tetiti20/Mowgli_PCB/README.md

# Mowgli_PCB
PI-HAT for mower OpenMower Mowgli project


https://github.com/Mowglifrenchtouch  
https://github.com/juditech3D/Guide-DIY-OpenMower-Mowgli-pour-Robots-Tondeuses-Yard500-et-500B

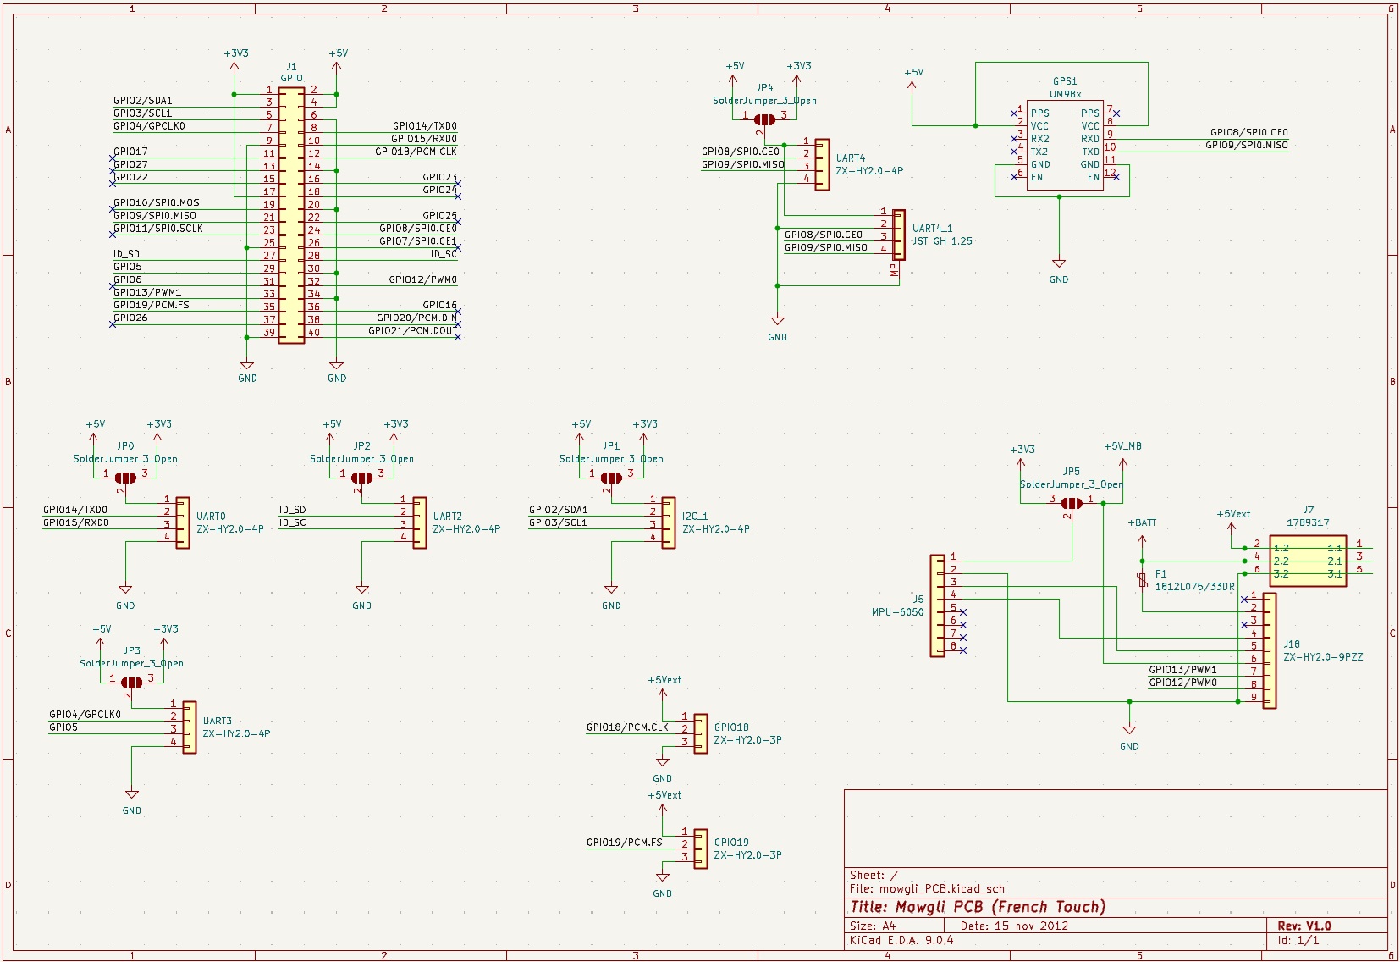
[picture p1: photos/Schéma.jpg]
schema
