tetiti20/Mowgli_PCB/Nomenclature Mowgli.ods

 | Prix lot | Prix Unitaire | Quantité | Total
Yardforce 500B classic | 329,00 € | 329,00 € | 1 | 329,00 € | https://www.jardin-affaires.com/materiels-de-motoculture/robot-tondeuse/robot-tondeuse-500-m-avec-bluetooth.html
Convertisseur DC/DC XL4015 | 3,19 € | 3,19 € | 1 | 3,19 € | https://fr.aliexpress.com/item/1005007105816094.html
MPU-6050 GY-521 | 2,87 € | 2,87 € | 1 | 2,87 € | https://fr.aliexpress.com/item/1005005281279590.html
Câble RG316 SMA female /MMCX 20cm | 1,83 € | 1,83 € | 1 | 1,83 € | https://fr.aliexpress.com/item/1005004620858652.html
GPS UM980 | 122,69 € | 122,69 € | 1 | 122,69 € | https://fr.aliexpress.com/item/1005007658786847.html
Antenne HA901A | 20,70 € | 20,70 € | 1 | 20,70 € | https://fr.aliexpress.com/item/1005007201937968.html
Stlink V2
Raspeberry PI4 4G | 50,00 € | 50,00 € | 1 | 50,00 € | leboncoin
SD 32Gb | 8,90 € | 8,90 € | 1 | 8,90 € | https://www.amazon.fr/SanDisk-M%C3%A9moire-microSDHC-Adaptateur-homologu%C3%A9e/dp/B08GY9NYRM?th=1 (https://www.amazon.fr/SanDisk-Mémoire-microSDHC-Adaptateur-homologuée/dp/B08GY9NYRM?th=1)
Clé USB TPLINK AC1300 | 16,99 € | 16,99 € | 1 | 16,99 € | https://www.amazon.fr/dp/B0859M539M?ref=ppx_yo2ov_dt_b_fed_asin_title&th=1
PCB | 9,46 € | 1,89 € | 1 | 1,89 € | PCBWAY
Fusible 1812L075/33DR | 5,85 € | 0,60 € | 1 | 0,60 € | https://fr.rs-online.com/web/p/products/7874259/
Connecteur femelle 2x20 | 2,99 € | 0,30 € | 1 | 0,30 € | https://fr.aliexpress.com/item/33004522737.html
Connecteur femelle 2x6 | 1,92 € | 0,19 € | 1 | 0,19 € | https://fr.aliexpress.com/item/33004522737.html
J18 09P HY2,0 | 6,39 € | 0,06 € | 1 | 0,06 € | https://fr.aliexpress.com/item/1005005320010110.html
3P HY2,0 | 3,39 € | 0,03 € | 2 | 0,07 € | https://fr.aliexpress.com/item/1005005320010110.html
4P HY2,0 | 3,69 € | 0,74 € | 5 | 3,69 € | https://fr.aliexpress.com/item/1005005320010110.html
Alim 3P 2,54mm | 1,69 € | 0,34 € | 1 | 0,34 € | https://fr.aliexpress.com/item/1005001924302591.html
colonnette M2,5 6mm | 3,29 € | 0,11 € | 8 | 0,88 € | https://fr.aliexpress.com/item/1005008285877374.html
colonnette M2,5 11mm | 2,79 € | 0,06 € | 8 | 0,45 € | https://fr.aliexpress.com/item/1005008285877374.html
vis M2,5 4mm | 3,19 € | 0,03 € | 11 | 0,35 € | https://fr.aliexpress.com/item/1005006724409373.html
vis M3 4mm | 3,19 € | 0,03 € | 4 | 0,13 € | https://fr.aliexpress.com/item/1005006724409373.html
câble HY2,0 9P 20cm Same direction | 3,59 € | 0,36 € | 1 | 0,36 € | https://fr.aliexpress.com/item/1005004823589756.html | https://fr.aliexpress.com/item/1005005902632327.html
Câble USB C 2P 25cm | 1,63 € | 1,63 € | 1 | 1,63 € | https://fr.aliexpress.com/item/1005006136130871.html
Câble paire HY2.0 4P | 5,29 € | 0,53 € | 1 | 0,53 € | https://fr.aliexpress.com/item/1005007328466759.html
Connecteur USB A à souder | 2,12 € | 0,42 € | 2 | 0,85 € | https://fr.aliexpress.com/item/1005005366707168.html
Inserts M3x5x4 | 2,06 | 0,04 € | 4 | 0,16 € | https://fr.aliexpress.com/item/1005003582355741.html
Inserts M2,5x4x4 | 1,81 | 0,04 € | 4 | 0,14 € | https://fr.aliexpress.com/item/1005003582355741.html
impression 3D |  |  |  |  | https://makerworld.com/fr/models/1362541-bloc-support-rpi-gnss-dcdc-f9p-yardforce-500b
 |  |  |  |  | https://www.printables.com/model/897864-clogging-protection-for-yardforce-classic-500
 |  |  |  |  | https://www.printables.com/model/1292412-openmower-logo-panel-for-yard-force-classic-500
 |  |  |  |  | https://www.printables.com/model/567409-yardforce-classic-500-wheel-spikes
 |  |  |  |  | https://www.printables.com/model/1000931-front-wheel-for-a-yardforce-mowbest-805b-yardforce
 |  |  |  |  | https://www.printables.com/model/1265826-yardforce-classic-500-front-wheel-boot
 |  |  |  |  | https://www.printables.com/model/957597-yardforce-tire-wheel
Total | 620,51 |  |  | 568,790533333333
