tetiti20/Mowgli_PCB/Kicad/mowgli_PCB.kicad_pcb

## KiCad design Kicad/mowgli_PCB.kicad_pcb (2025-05-22)

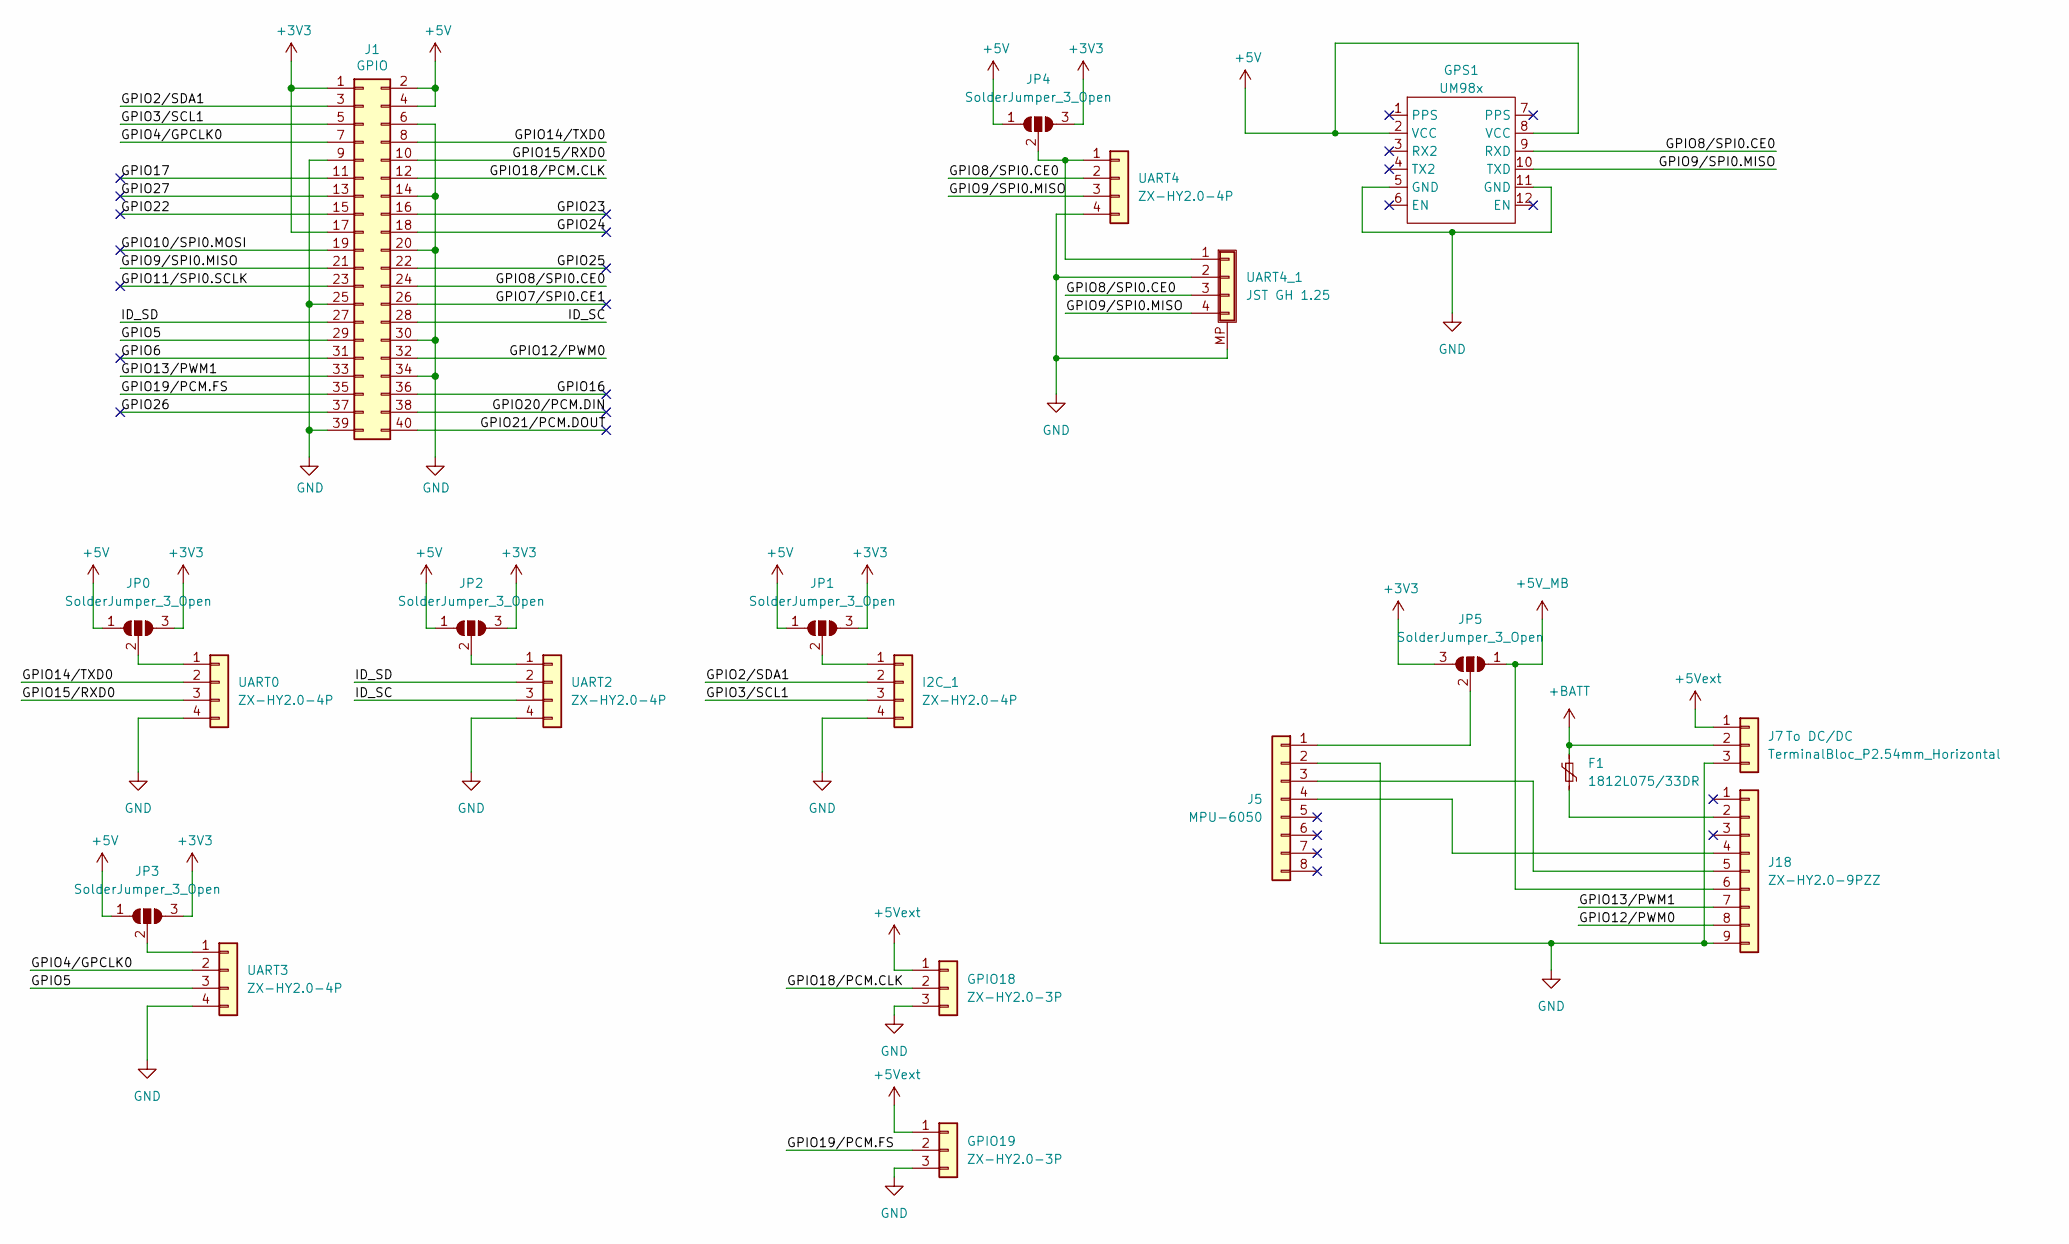
[picture p2: schematic mowgli_PCB.kicad_sch, Mowgli PCB (French Touch)]

Parts:
F1: 1812L075/33DR; Fuse_1812_4532Metric
GPIO18, GPIO19: ZX-HY2.0-3P; Connector_JST_HY2.0_1x03_P2.00mm_THT
GPS1: UM98x; UM9XX_WitMotion
I2C_1: ZX-HY2.0-4P; Connector_JST_HY2.0_1x04_P2.00mm_THT_1
J1: GPIO; PinSocket_2x20_P2.54mm_Vertical
J5: MPU-6050; GY-521
J7: TerminalBloc_P2.54mm_Horizontal; TerminalBlock_Phoenix_MPT-0,5-3-2.54_1x03_P2.54mm_Horizontal
J18: ZX-HY2.0-9PZZ; Connector_JST_HY2.0_1x09_P2.00mm_THT_1_1
JP0, JP1, JP2, JP3, JP4, JP5: SolderJumper_3_Open; SolderJumper-3_P1.3mm_Open_RoundedPad1.0x1.5mm
UART0, UART2, UART3, UART4: ZX-HY2.0-4P; Connector_JST_HY2.0_1x04_P2.00mm_THT_1
UART4_1: JST GH 1.25; JST_GH_SM04B-GHS-TB_1x04-1MP_P1.25mm_Horizontal

Connections:
+3V3: J1.1, J1.17, JP0.3 (B), JP1.3 (B), JP2.3 (B), JP3.3 (B), JP4.3 (B), JP5.3 (B)
+5V: GPS1.2 (VCC), GPS1.8 (VCC), J1.2, J1.4, JP0.1 (A), JP1.1 (A), JP2.1 (A), JP3.1 (A), JP4.1 (A)
+5V_MB: J18.6, JP5.1 (A)
+5Vext: GPIO18.1, GPIO19.1, J7.1
+BATT: F1.1, J7.2
/GPIO2/SDA1: I2C_1.2, J1.3
/GPIO3/SCL1: I2C_1.3, J1.5
/GPIO4/GPCLK0: J1.7, UART3.2
/GPIO5: J1.29, UART3.3
/GPIO6: J1.31
/GPIO7/SPI0.CE1: J1.26
/GPIO8/SPI0.CE0: GPS1.9 (RXD), J1.24, UART4.2, UART4_1.3
/GPIO9/SPI0.MISO: GPS1.10 (TXD), J1.21, UART4.3, UART4_1.4
/GPIO10/SPI0.MOSI: J1.19
/GPIO11/SPI0.SCLK: J1.23
/GPIO12/PWM0: J1.32, J18.8
/GPIO13/PWM1: J1.33, J18.7
/GPIO14/TXD0: J1.8, UART0.2
/GPIO15/RXD0: J1.10, UART0.3
/GPIO16: J1.36
/GPIO17: J1.11
/GPIO18/PCM.CLK: GPIO18.2, J1.12
/GPIO19/PCM.FS: GPIO19.2, J1.35
/GPIO20/PCM.DIN: J1.38
/GPIO21/PCM.DOUT: J1.40
/GPIO22: J1.15
/GPIO23: J1.16
/GPIO24: J1.18
/GPIO25: J1.22
/GPIO26: J1.37
/GPIO27: J1.13
/ID_SC: J1.28, UART2.3
/ID_SD: J1.27, UART2.2
GND: GPIO18.3, GPIO19.3, GPS1.5 (GND), GPS1.11 (GND), I2C_1.4, J1.6, J1.9, J1.14, J1.20, J1.25, J1.30, J1.34, J1.39, J5.2, J7.3, J18.9, UART0.4, UART2.4, UART3.4, UART4.4, UART4_1.2, UART4_1.MP (Shield)
unnamed: I2C_1.1, JP1.2 (C)
unnamed: J5.1, JP5.2 (C)
unnamed: F1.2, J18.2
unnamed: J5.4, J18.4
unnamed: J5.3, J18.5
unnamed: JP0.2 (C), UART0.1
unnamed: JP2.2 (C), UART2.1
unnamed: JP3.2 (C), UART3.1
unnamed: JP4.2 (C), UART4.1, UART4_1.1

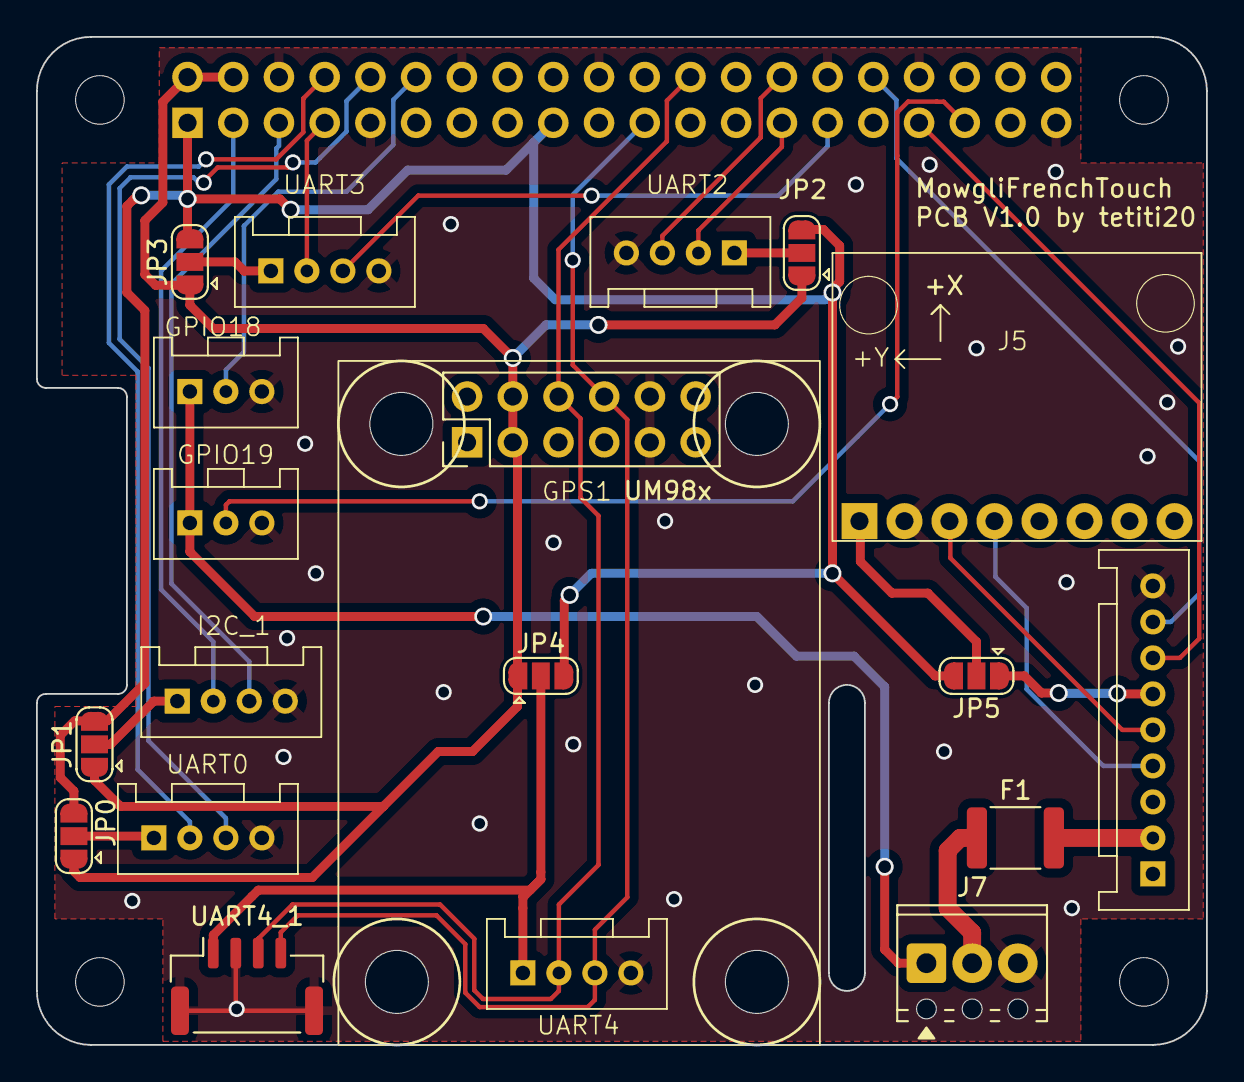
[picture p3: board mowgli_PCB.kicad_pcb from above]

Board: 2 copper layers, 65.0 x 56.0 mm, 24 parts (1 on the bottom side), 29 nets.

Other parts of the board:
MH1, MH2, MH3, MH4: MountingHole_2.7mm_M2.5
