tetiti20/Mowgli_PCB/(commit log)

2025-05-12 First version
    [mowgli_PCB.kicad_pcb, mowgli_PCB.kicad_sch]
2025-05-22 Correction inversion des pin 4 et 6 de J18
    [mowgli_PCB.kicad_pcb, mowgli_PCB.kicad_sch]
2025-05-22 Maj plan de masse après modif J18
    [mowgli_PCB.kicad_pcb]
